kurowskitomek/AHRS/Docs/img/Step-Up_Voltage_Regulator.jpg

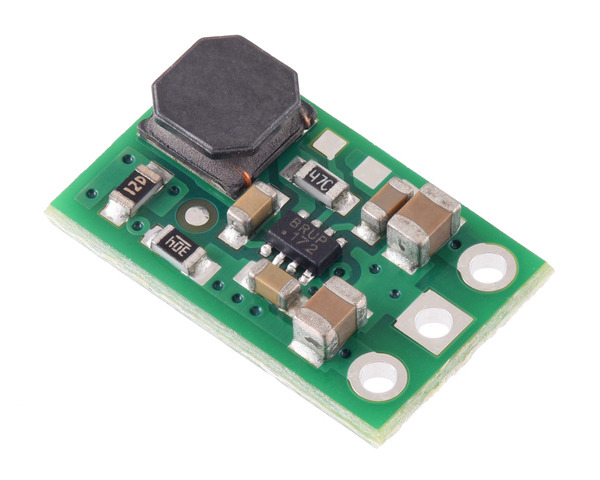
Docs/img/Step-Up_Voltage_Regulator.jpg
