kurowskitomek/AHRS/Docs/img/Slider_Switch.png

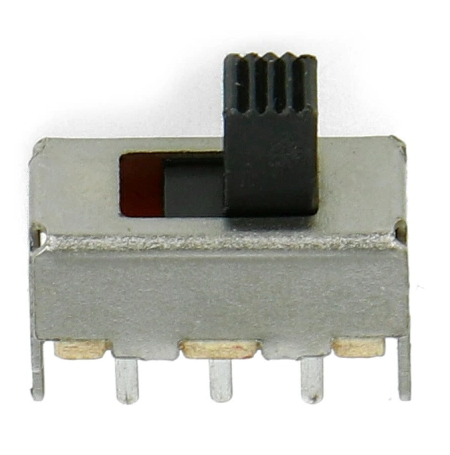
Docs/img/Slider_Switch.png
