kurowskitomek/AHRS/Docs/img/AHRS_architektura_systemu.png

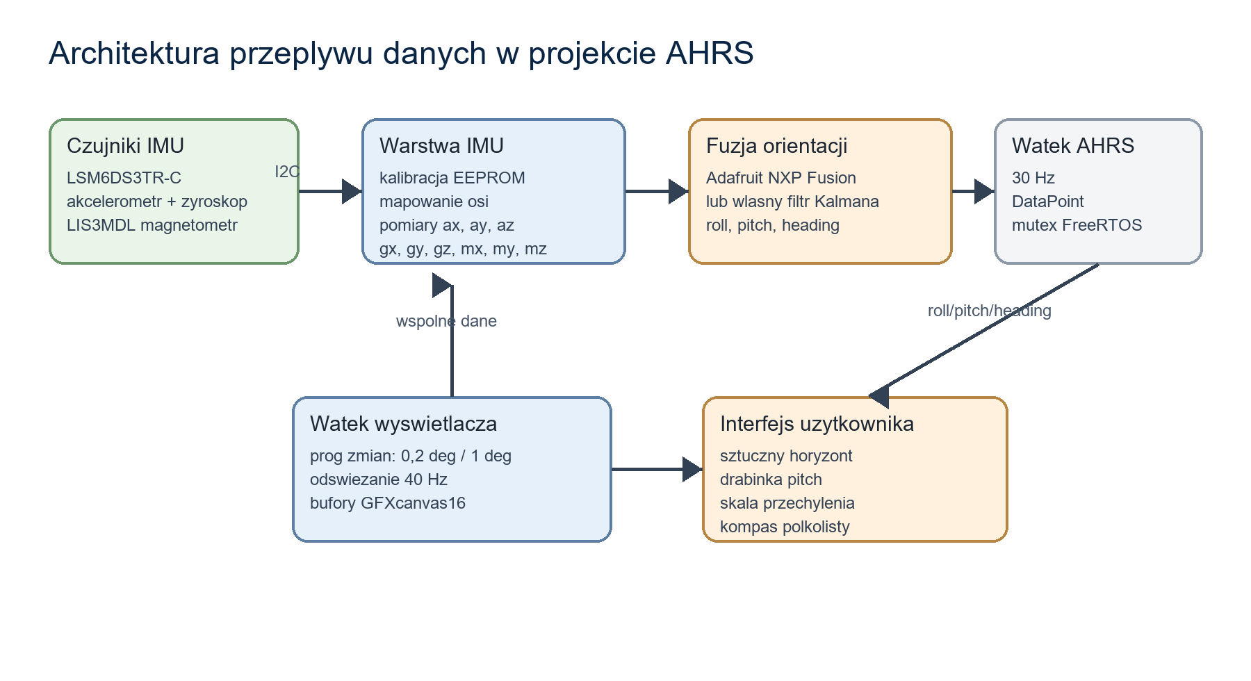
Docs/img/AHRS_architektura_systemu.png
