kurowskitomek/AHRS/Docs/img/LCD.png

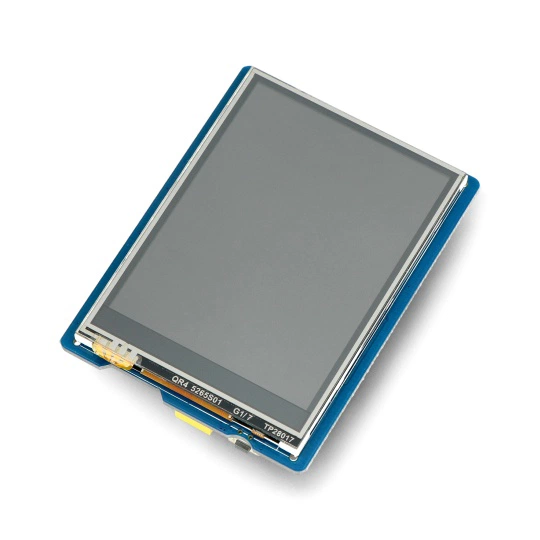
Docs/img/LCD.png
