kurowskitomek/AHRS/Docs/img/Nano_Terminal_Adapter.png

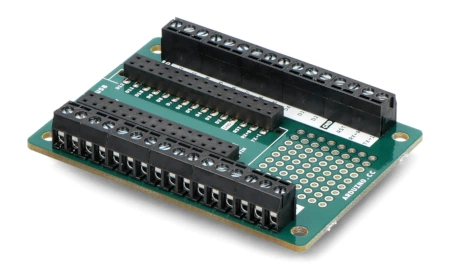
Docs/img/Nano_Terminal_Adapter.png
