kurowskitomek/AHRS/Electrical_schematics/PowerSupply.png

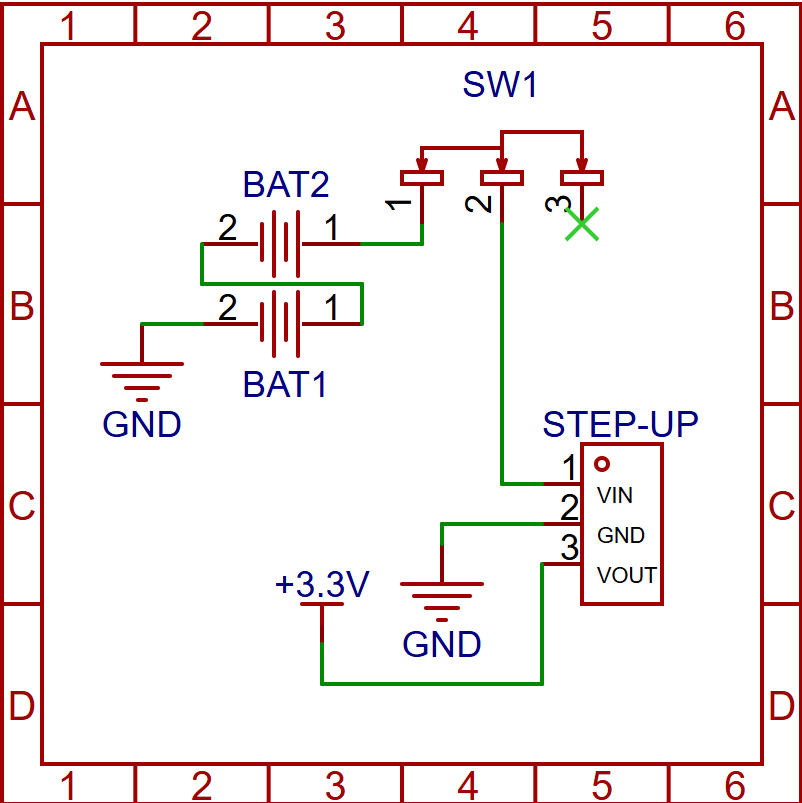
Electrical_schematics/PowerSupply.png
