kurowskitomek/AHRS/Electrical_schematics/Prototyping_Area.png

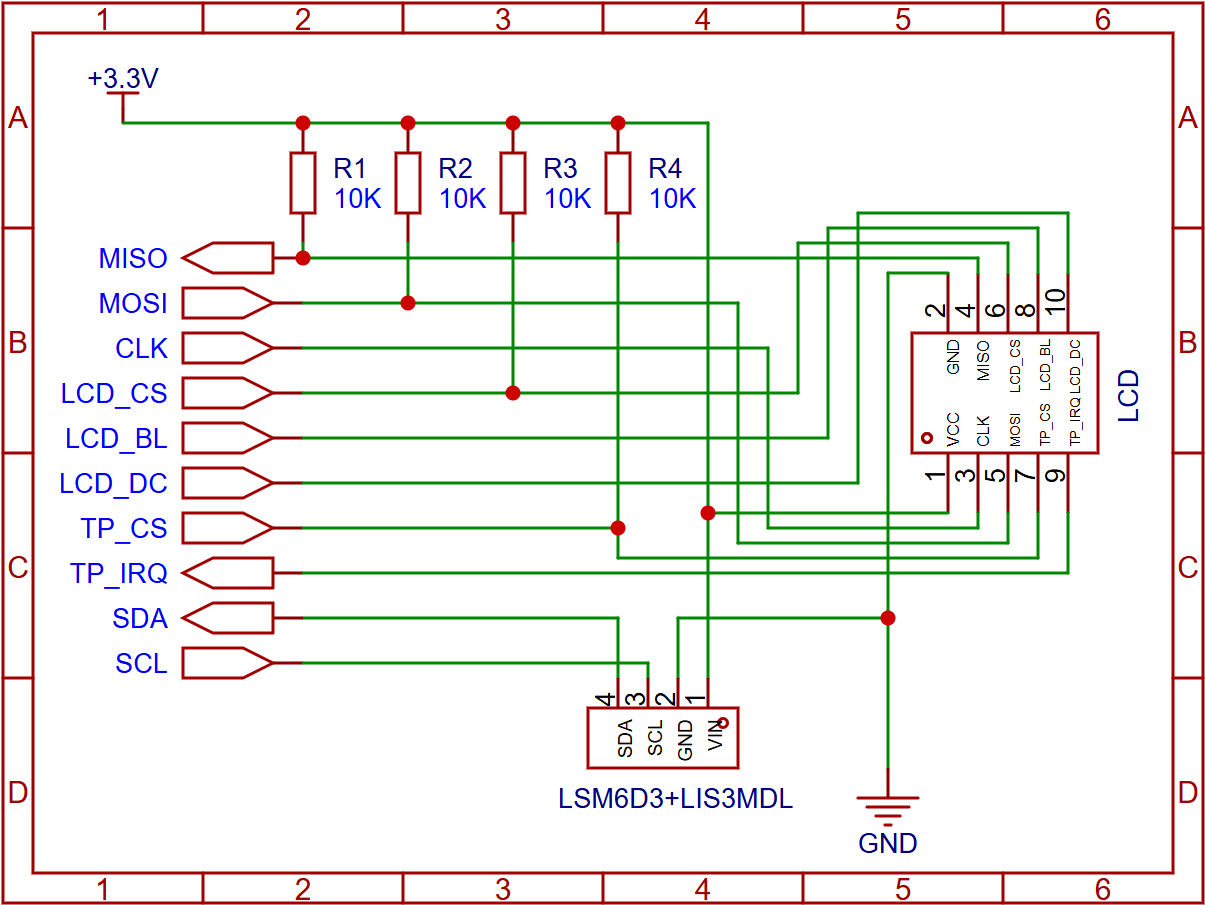
Electrical_schematics/Prototyping_Area.png
