kurowskitomek/AHRS/Case/3dModels/Case.SLDPRT

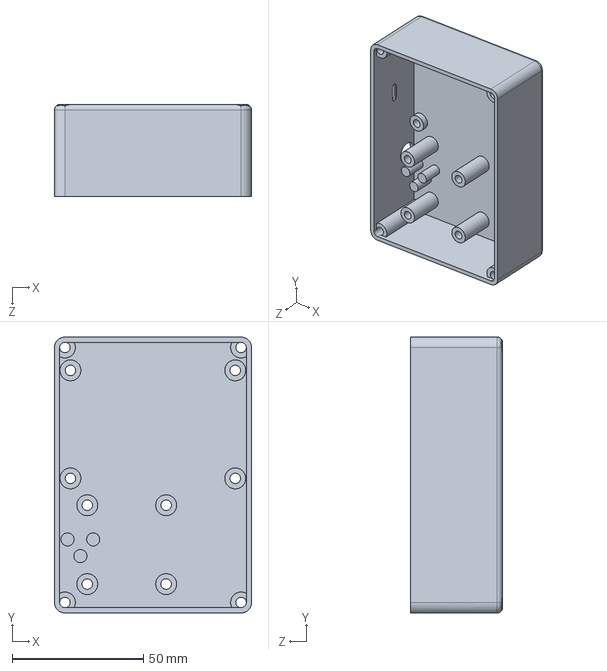
[picture p22: CAD file, 2026-05-18]
Case/3dModels/Case.SLDPRT
75.0 x 105.0 x 35.0 mm
