kurowskitomek/AHRS/Case/3dModels/AHRS.SLDASM

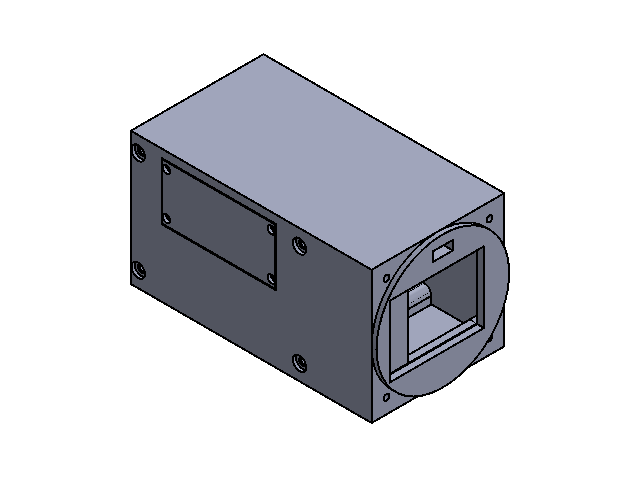
[picture p23: CAD file, 2026-05-18]
Case/3dModels/AHRS.SLDASM
Case
Front
BatteryCover
