kurowskitomek/AHRS/(list of files, cad)

Other CAD files:
Case/3dModels/BatteryCover.SLDPRT
Case/3dModels/Front.SLDPRT
Case/3dPrint/BatteryCover.STL
Case/3dPrint/Case.STL
Case/3dPrint/Front.STL
Case/Technical_Drawings/AHRS.SLDDRW
