kurowskitomek/AHRS/Docs/img/MotionCal_CalibrationResult.png

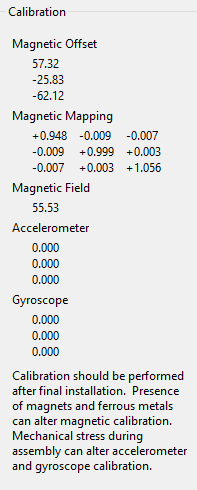
Docs/img/MotionCal_CalibrationResult.png
