kurowskitomek/AHRS/Case/Technical_Drawings/Case.pdf

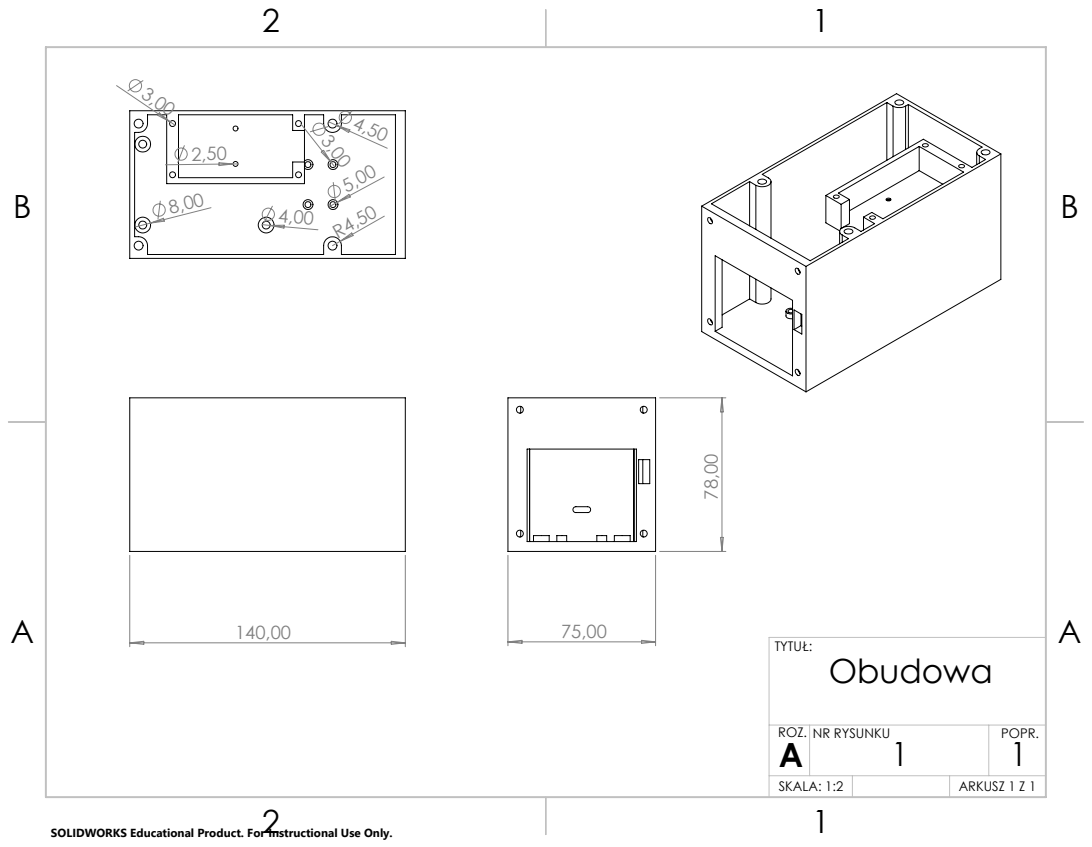
[picture p25: page 1]

ROZ. A | NR RYSUNKU 1 | POPR. 1

SKALA: 1:2 | | ARKUSZ 1 Z 1

SOLIDWORKS Educational Product. For Instructional Use Only.
